fmileto/Vaso/img/1661767672209.jpg

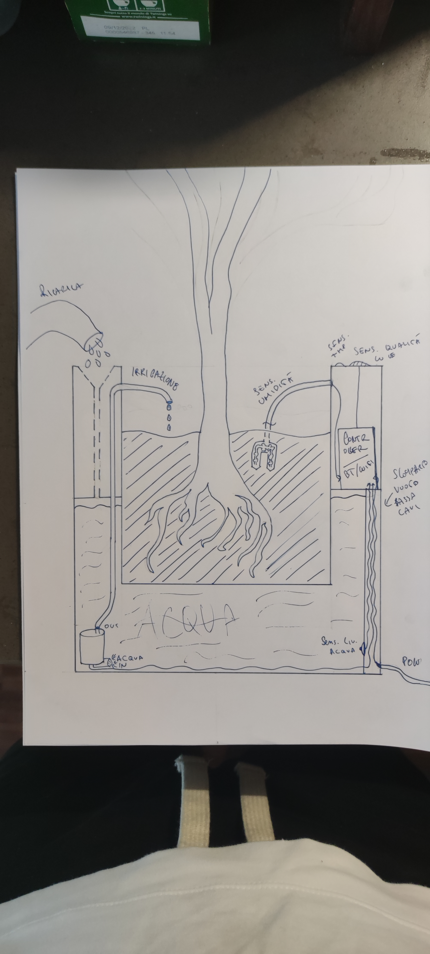
img/1661767672209.jpg
