fmileto/Vaso/flaura/images/Water_Pump_Mount.png

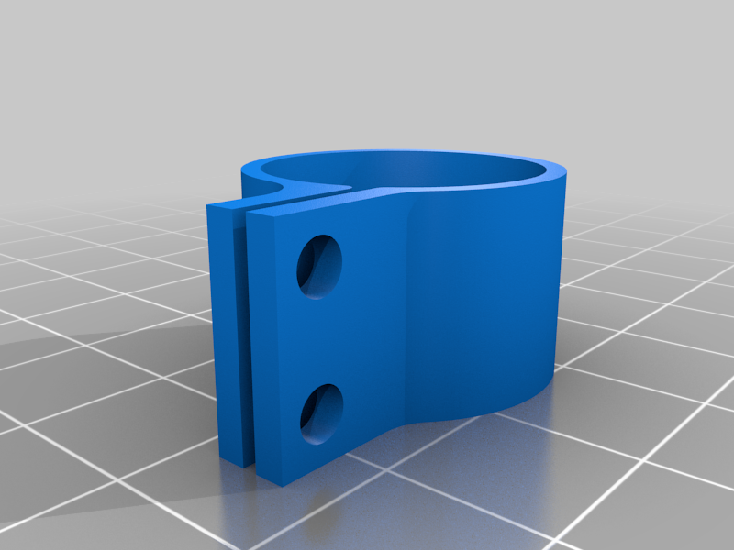
flaura/images/Water_Pump_Mount.png
