fmileto/Vaso/flaura/images/Flaura_circuit_diagram_V1_0.png

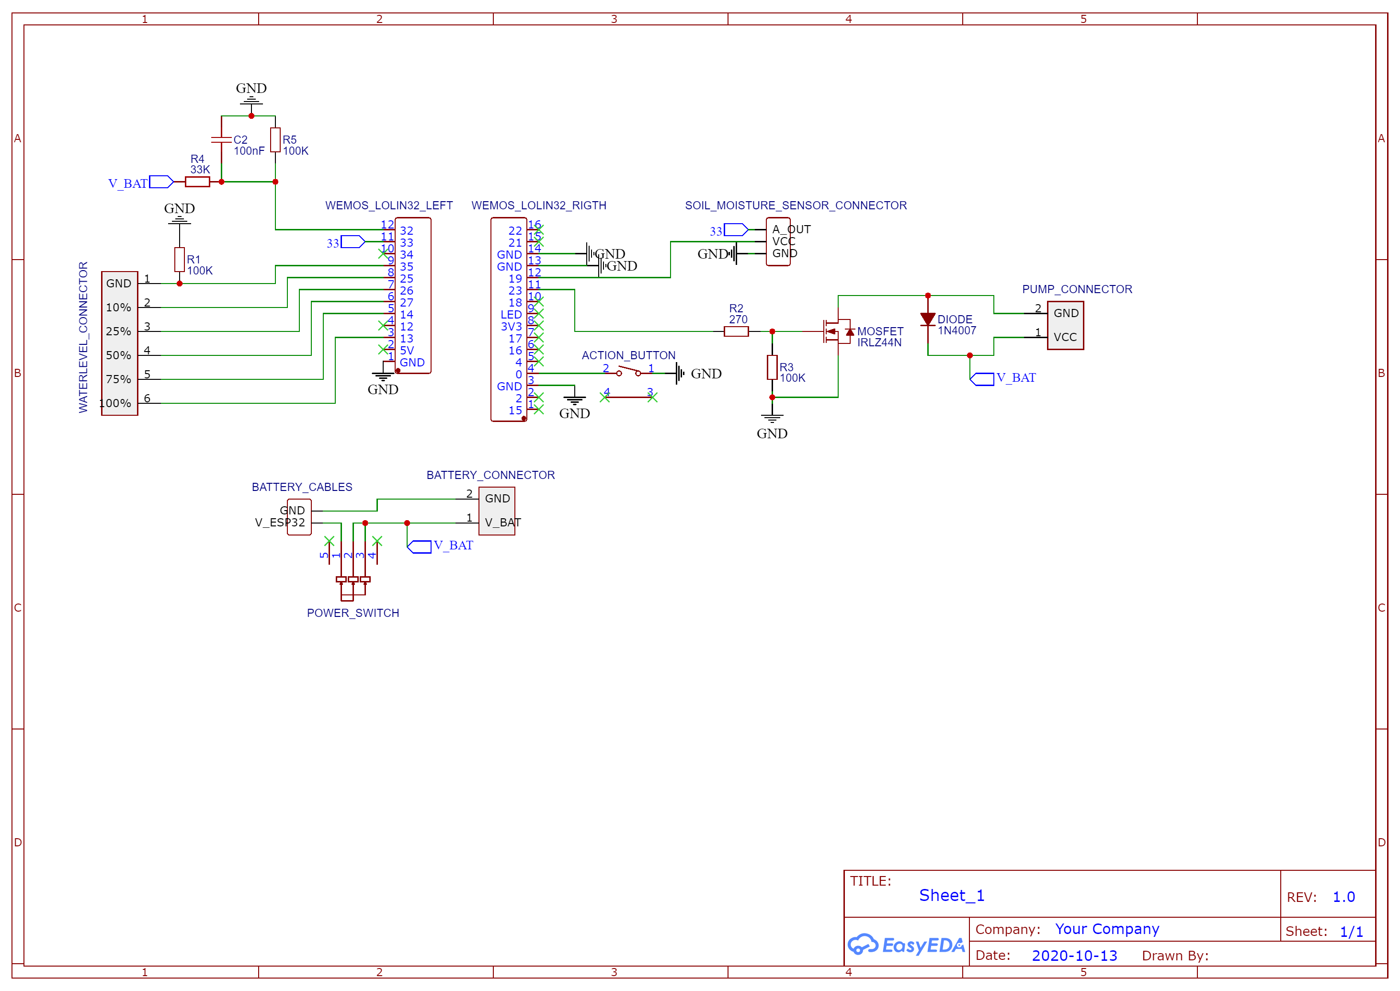
flaura/images/Flaura_circuit_diagram_V1_0.png
