fmileto/Vaso/flaura/images/Housing_Bottom.png

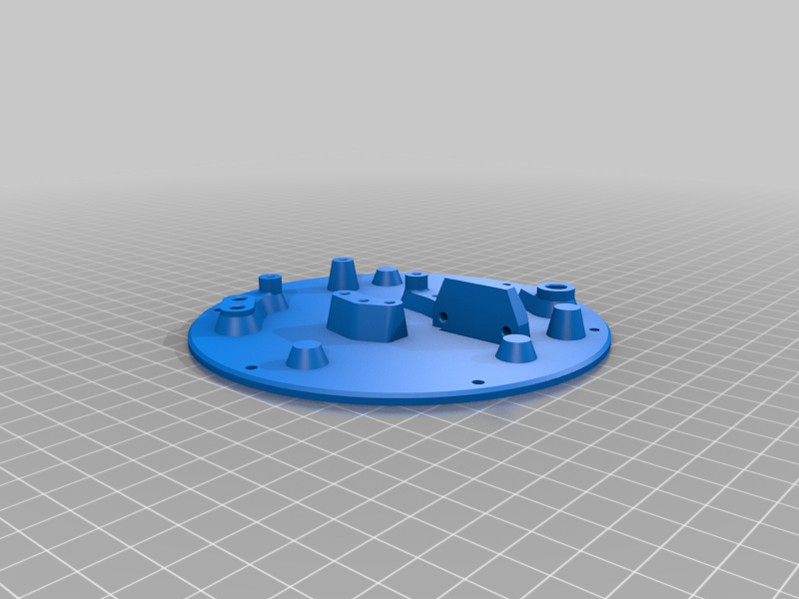
flaura/images/Housing_Bottom.png
