fmileto/Vaso/flaura/images/Housing_Inside.png

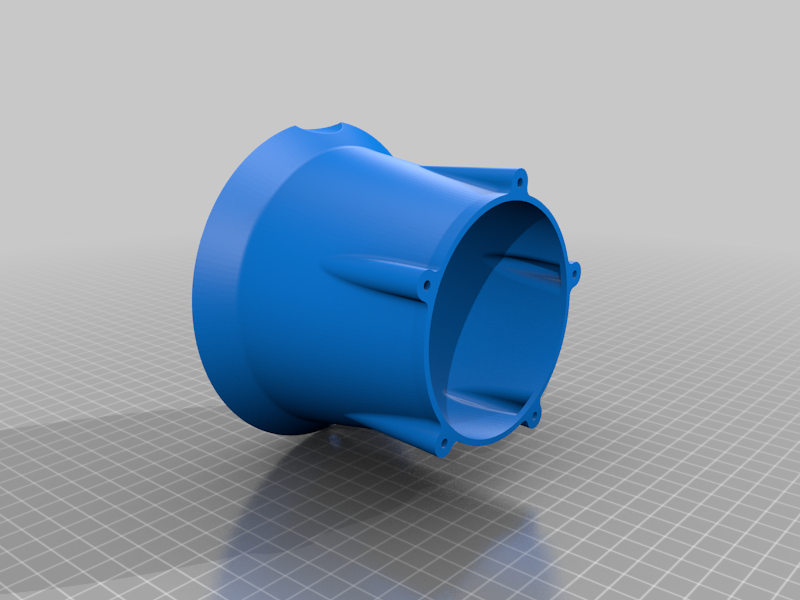
flaura/images/Housing_Inside.png
