fmileto/Vaso/flaura/images/Sketch.PNG

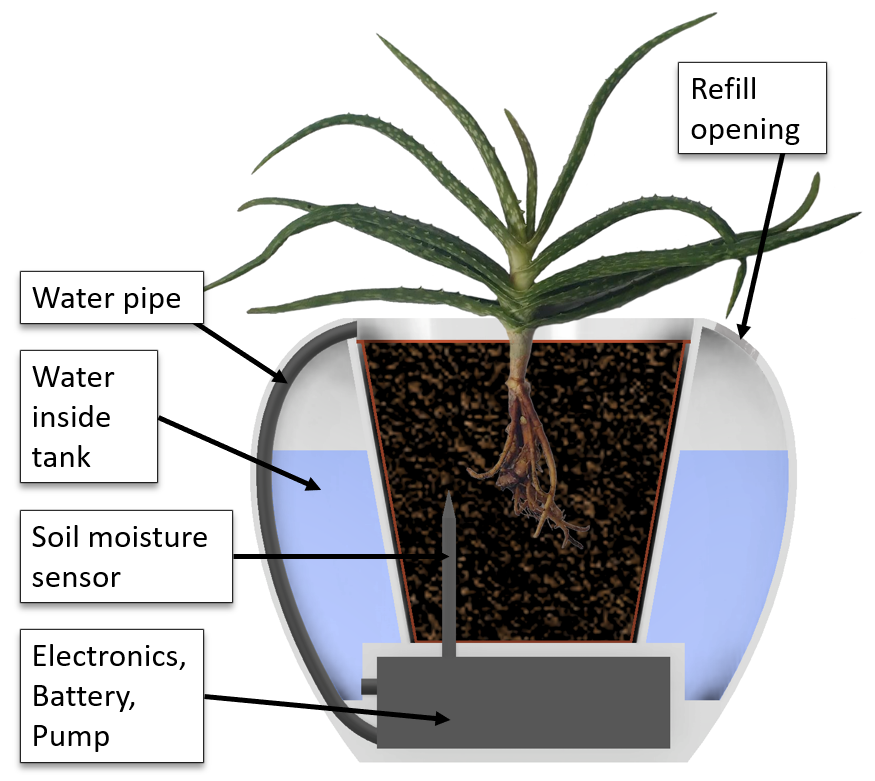
flaura/images/Sketch.PNG
