fmileto/Vaso/flaura/images/Thingiverse-min.jpeg

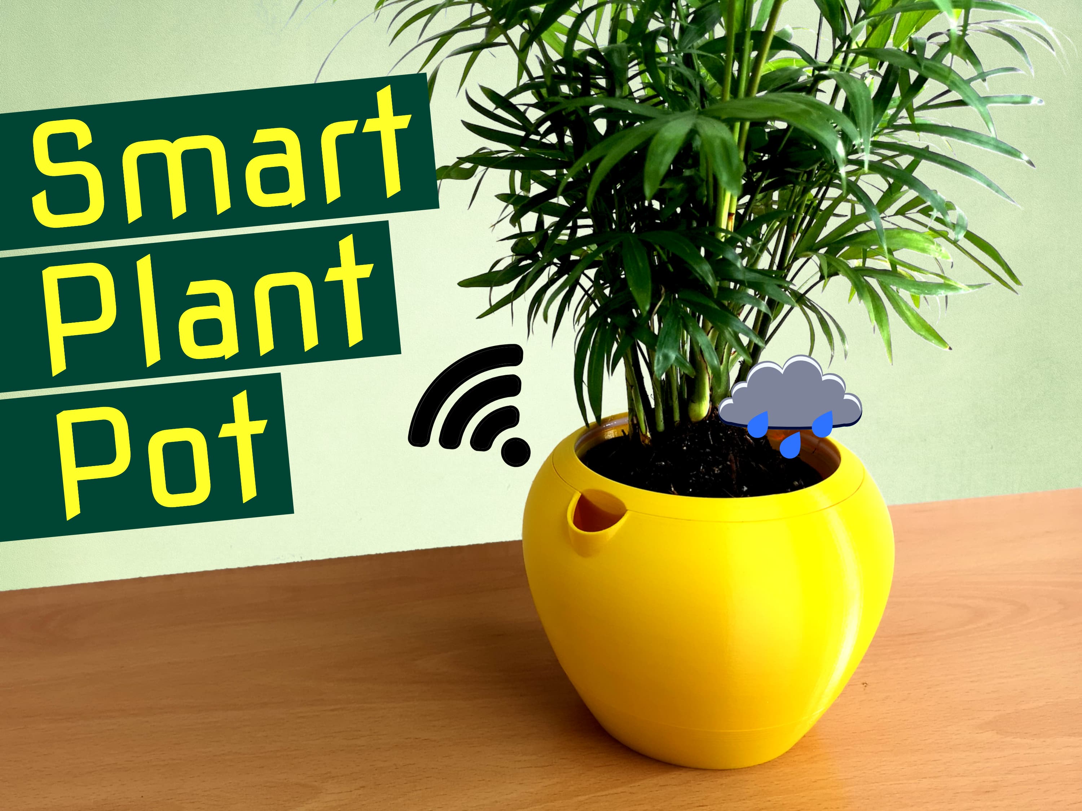
flaura/images/Thingiverse-min.jpeg
