fmileto/Vaso/flaura/images/Thumbnail3.jpg

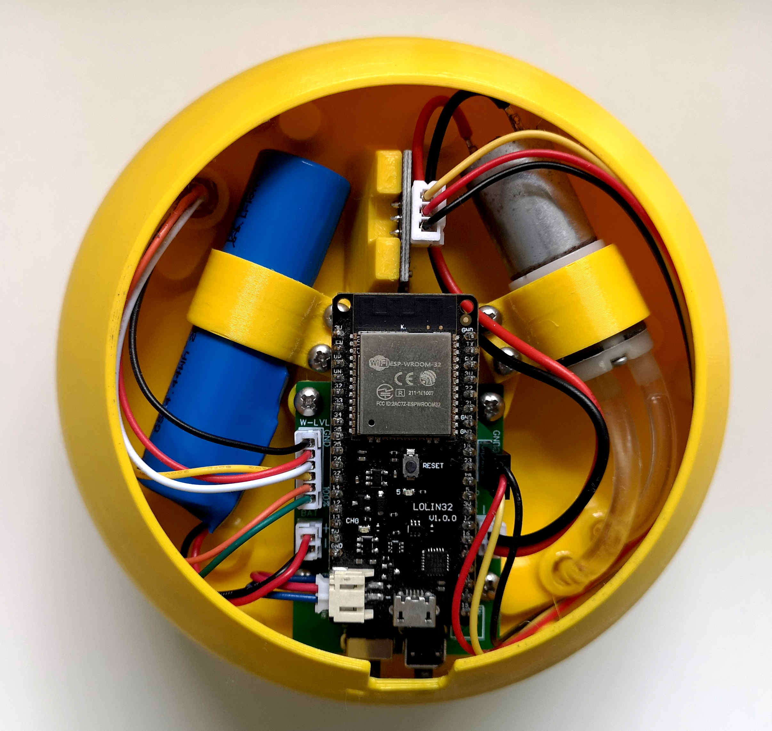
flaura/images/Thumbnail3.jpg
