fmileto/Vaso/flaura/images/Thumbnail7.jpg

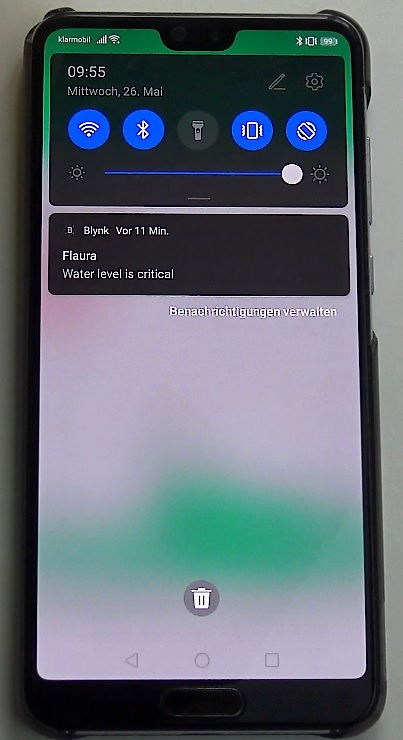
flaura/images/Thumbnail7.jpg
