fmileto/Vaso/flaura/images/Thumbnail8.jpg

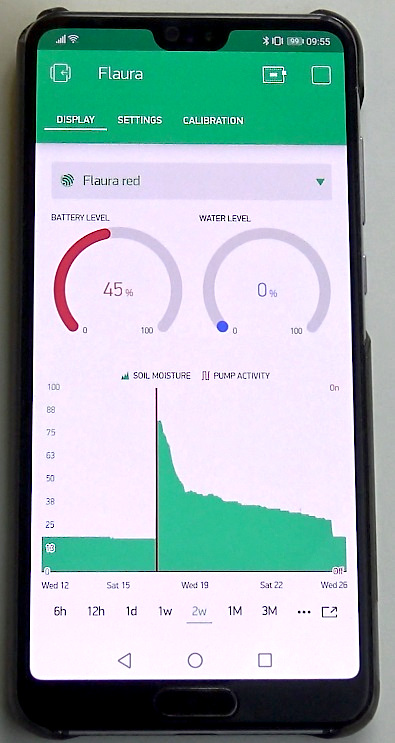
flaura/images/Thumbnail8.jpg
