fmileto/Vaso/flaura/images/Thumbnail9.jpg

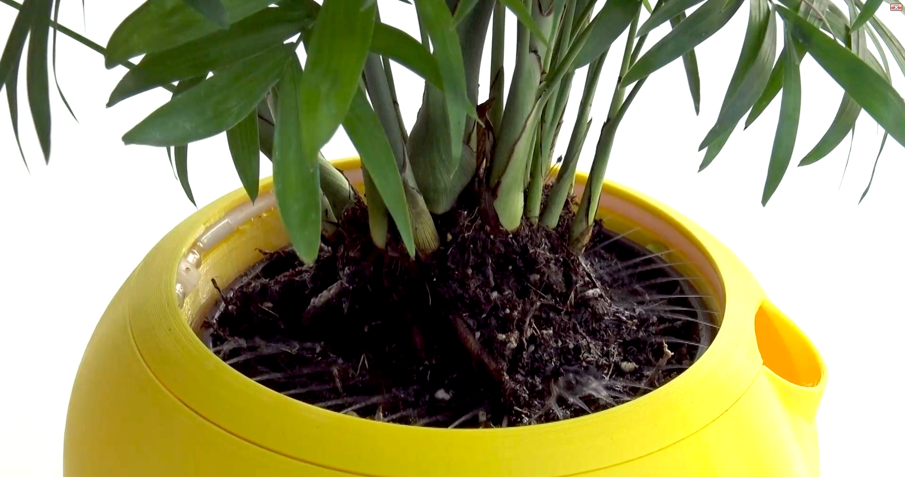
flaura/images/Thumbnail9.jpg
