fmileto/Vaso/flaura/images/Water_Level_Sensor_Mount.png

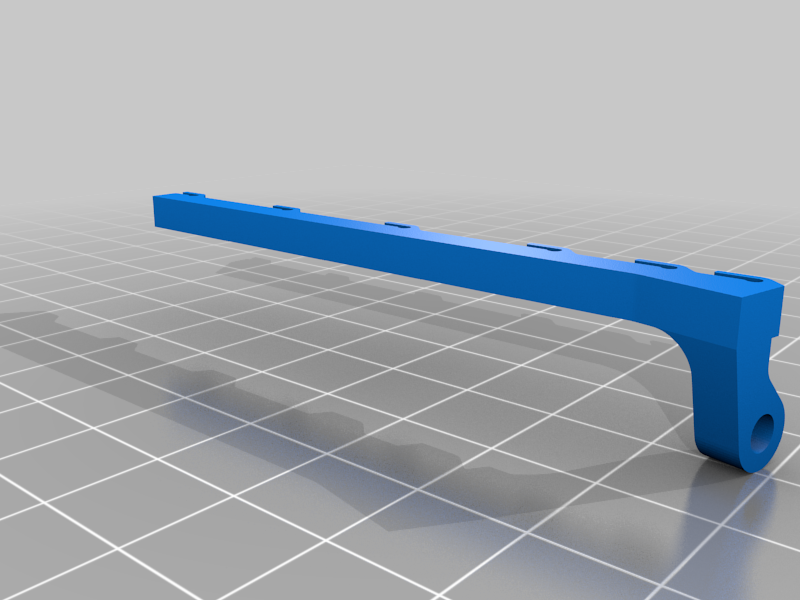
flaura/images/Water_Level_Sensor_Mount.png
