fmileto/Vaso/img/1661767672200.jpg

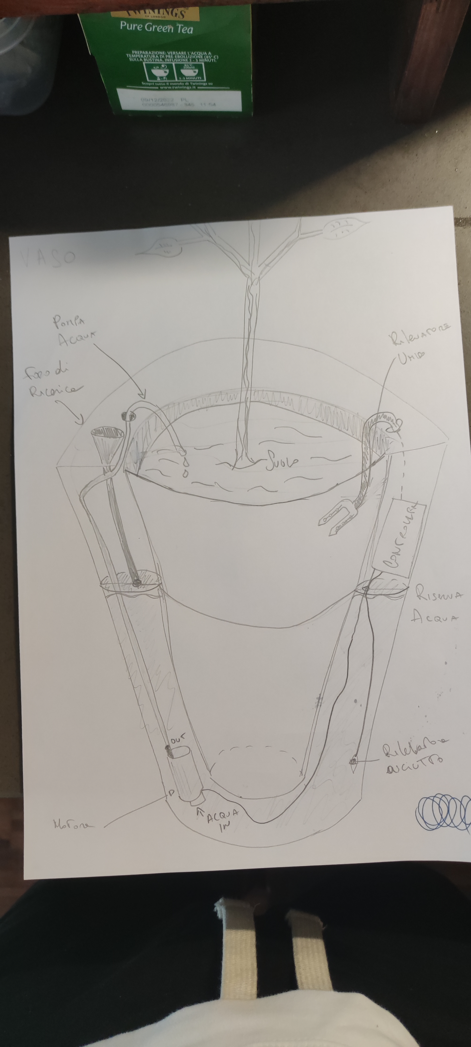
img/1661767672200.jpg
