fmileto/Vaso/img/1661767672217.jpg

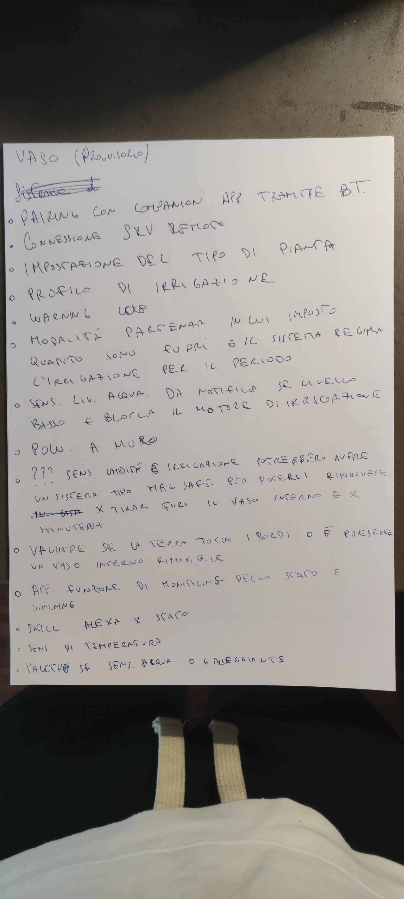
img/1661767672217.jpg
