fmileto/Vaso/flaura/files/Water_Pump_Mount.stl

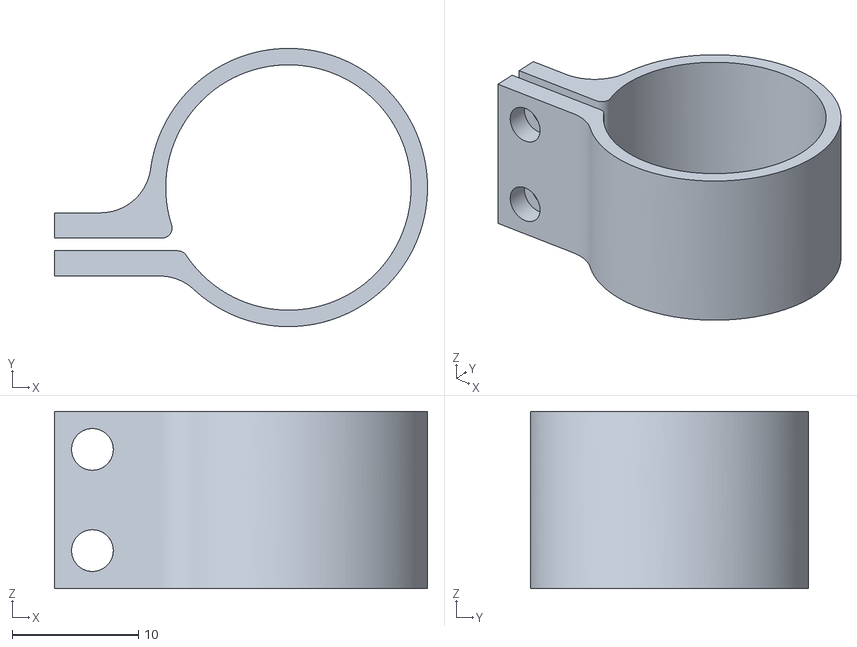
[picture p15: CAD file, 2022-09-05]
flaura/files/Water_Pump_Mount.stl
29.5 x 22.0 x 14.0
