fmileto/Vaso/flaura/files/Battery_Mount.stl

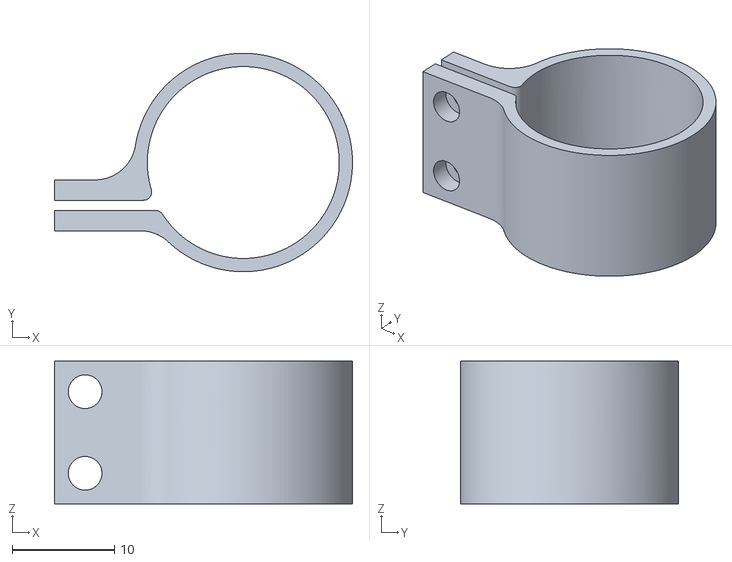
[picture p16: CAD file, 2022-09-05]
flaura/files/Battery_Mount.stl
29.2 x 21.4 x 14.0
