fmileto/Vaso/flaura/files/Water_Level_Sensor_Mount.stl

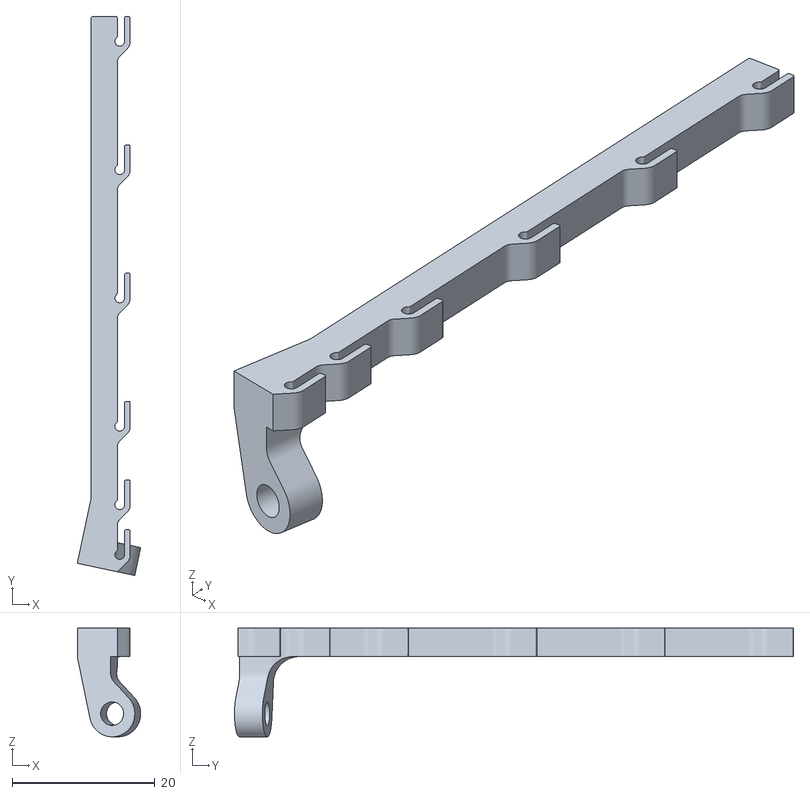
[picture p17: CAD file, 2022-09-05]
flaura/files/Water_Level_Sensor_Mount.stl
8.90 x 78.4 x 15.2
