fmileto/Vaso/flaura/files/Housing_Inside.stl

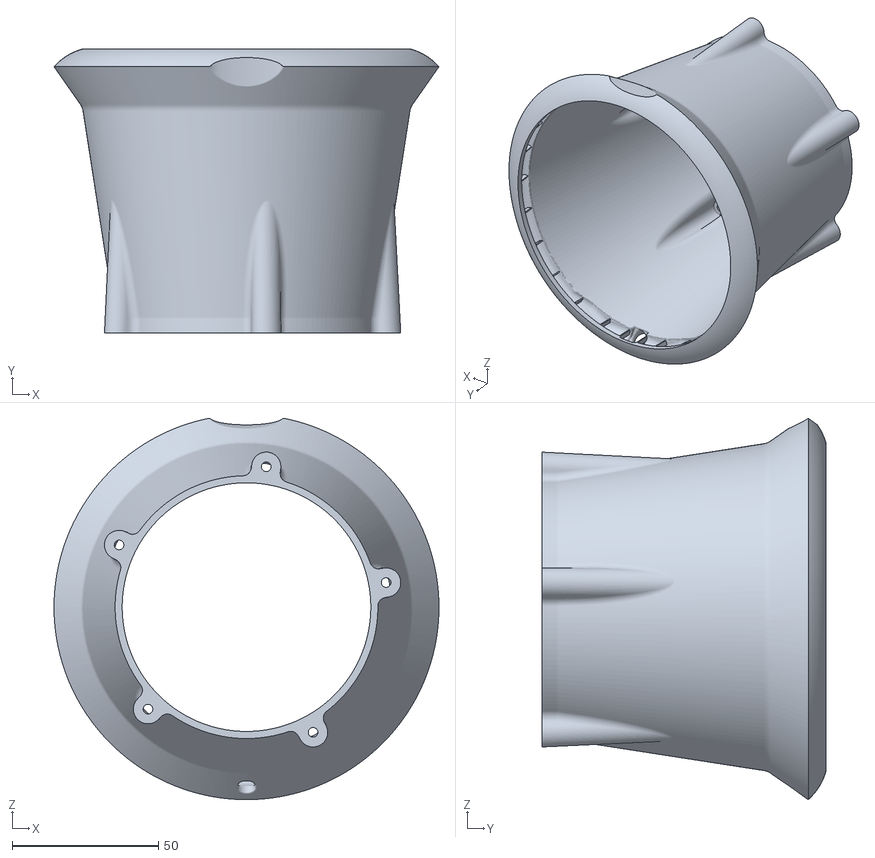
[picture p18: CAD file, 2022-09-05]
flaura/files/Housing_Inside.stl
131.7 x 97.0 x 130.4
