fmileto/Vaso/flaura/files/Housing_Outside.stl

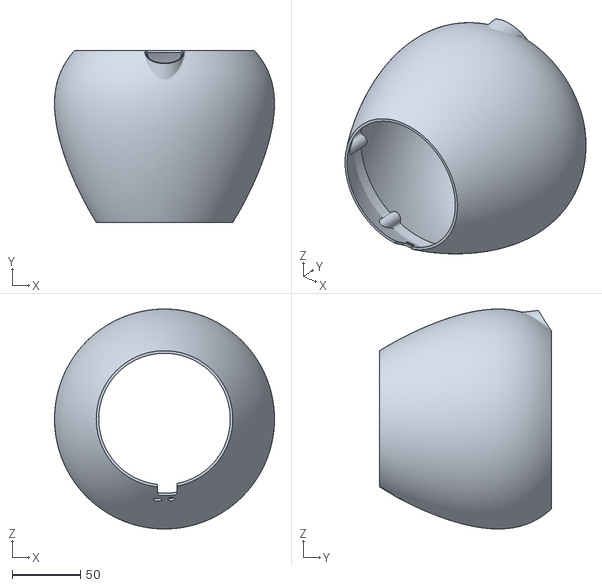
[picture p19: CAD file, 2022-09-05]
flaura/files/Housing_Outside.stl
161.2 x 125.8 x 161.1
