fmileto/Vaso/flaura/files/Housing_Bottom.stl

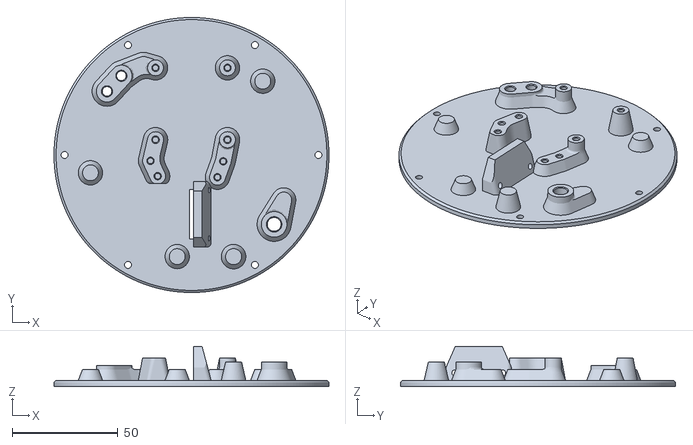
[picture p20: CAD file, 2022-09-05]
flaura/files/Housing_Bottom.stl
130.0 x 130.0 x 19.0
