fmileto/Vaso/VasoBlynk/VasoBlynk/Settings.h

/*
 * General options
 */

#define BOARD_HARDWARE_VERSION "1.0.0"

/*
 * Board configuration (see examples below).
 */

#if defined(USE_WROVER_BOARD)

// Custom board configuration
#define BOARD_BUTTON_PIN 15          // Pin where user button is attached
#define BOARD_BUTTON_ACTIVE_LOW true // true if button is "active-low"

#define BOARD_LED_PIN_R 0 // Set R,G,B pins - if your LED is PWM RGB
#define BOARD_LED_PIN_G 2
#define BOARD_LED_PIN_B 4
#define BOARD_LED_INVERSE false  // true if LED is common anode, false if common cathode
#define BOARD_LED_BRIGHTNESS 128 // 0..255 brightness control

#else

// Custom board configuration
#define BOARD_BUTTON_PIN 0           // Pin where user button is attached
#define BOARD_BUTTON_ACTIVE_LOW true // true if button is "active-low"

#define BOARD_LED_PIN 5         // Set LED pin - if you have a single-color LED attached
//#define BOARD_LED_PIN_R           27                    // Set R,G,B pins - if your LED is PWM RGB
//#define BOARD_LED_PIN_G           26
//#define BOARD_LED_PIN_B           25
//#define BOARD_LED_PIN_WS2812      33                    // Set if your LED is WS2812 RGB
#define BOARD_LED_INVERSE false // true if LED is common anode, false if common cathode
#define BOARD_LED_BRIGHTNESS 64 // 0..255 brightness control

#endif

/*
 * Advanced options
 */

#define BUTTON_HOLD_TIME_INDICATION 3000
#define BUTTON_HOLD_TIME_ACTION 4000

#define BOARD_PWM_MAX 1023

#define LEDC_CHANNEL_1 1
#define LEDC_CHANNEL_2 2
#define LEDC_CHANNEL_3 3
#define LEDC_TIMER_BITS 10
#define LEDC_BASE_FREQ 12000

#define CONFIG_AP_URL "blynk.setup"
#define CONFIG_DEFAULT_SERVER "blynk.cloud"
#define CONFIG_DEFAULT_PORT 443

#define WIFI_NET_CONNECT_TIMEOUT 30000
#define WIFI_CLOUD_CONNECT_TIMEOUT 30000
#define WIFI_AP_CONFIG_PORT 80
#define WIFI_AP_IP IPAddress(192, 168, 4, 1)
#define WIFI_AP_Subnet IPAddress(255, 255, 255, 0)
//#define WIFI_CAPTIVE_PORTAL_ENABLE

#define USE_TICKER
//#define USE_TIMER_ONE
//#define USE_TIMER_THREE

#define BLYNK_NO_DEFAULT_BANNER

#if defined(APP_DEBUG)
#define DEBUG_PRINT(...) BLYNK_LOG1(__VA_ARGS__)
#else
#define DEBUG_PRINT(...)
#endif
